TumAro/5_bar/README.md

# 5 Bar Linkage Mechanism
- Can get the parts list [here](specs/parts.md)

# TODO
- write up about the whole journey [here](https://blog.tumin.dev/5_bar)
- upload the updated STLs in the /specs folder
