TumAro/5_bar/specs/system.md

# COM (from axis)
- Left Cranker: 75mm
- Right Cranker: 75mm
- Left Coupler: 95mm
- Right Coupler: 95mm

# weights
- Left Cranker: 133gm
- Right Cranker: 133gm
- Left Coupler: 175gm
- Right Coupler: 175gm

# pivot (axis2axis)
- Left proximal = Right proximal: 150mm
- Left distal = Right distal: 200mm
- Base: 150mm
