TumAro/5_bar/markers/markers_A4.pdf

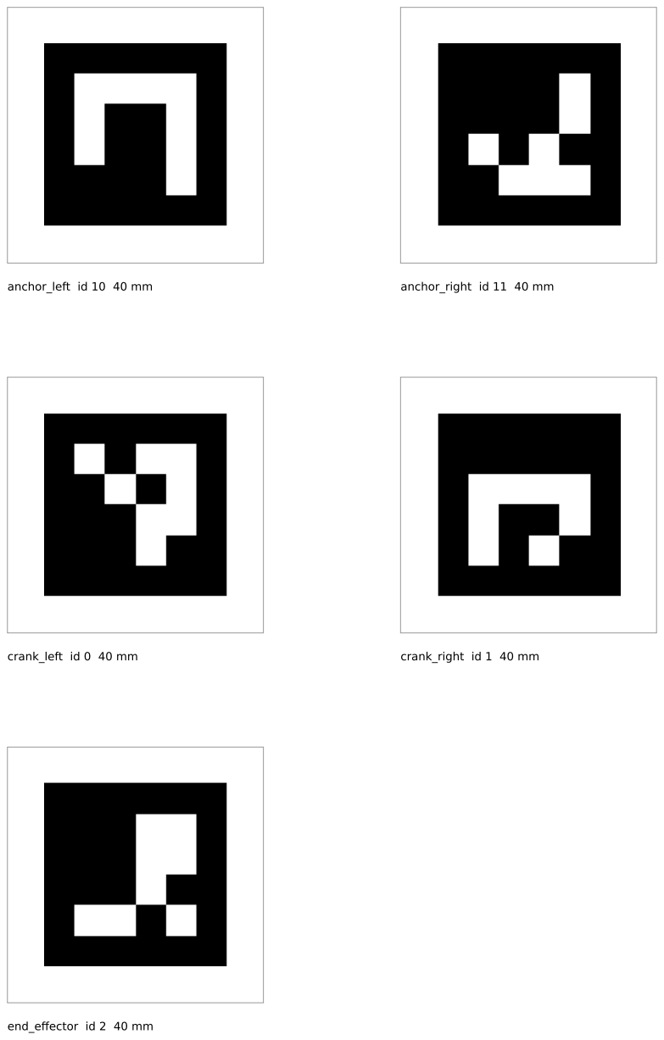
[picture p2: page 1]

anchor_left id 10 40 mm | anchor_right id 11 40 mm
crank_left id 0 40 mm | crank_right id 1 40 mm

end_effector id 2 40 mm
