TumAro/5_bar/markers/anchor_left_30mm.png

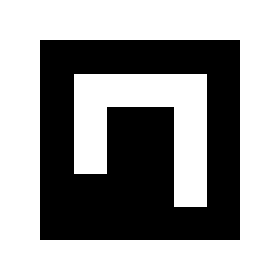
markers/anchor_left_30mm.png
