TumAro/5_bar/markers/anchor_right_30mm.png

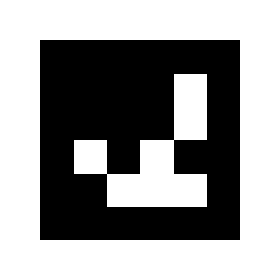
markers/anchor_right_30mm.png
