TumAro/5_bar/markers/crank_left_40mm.png

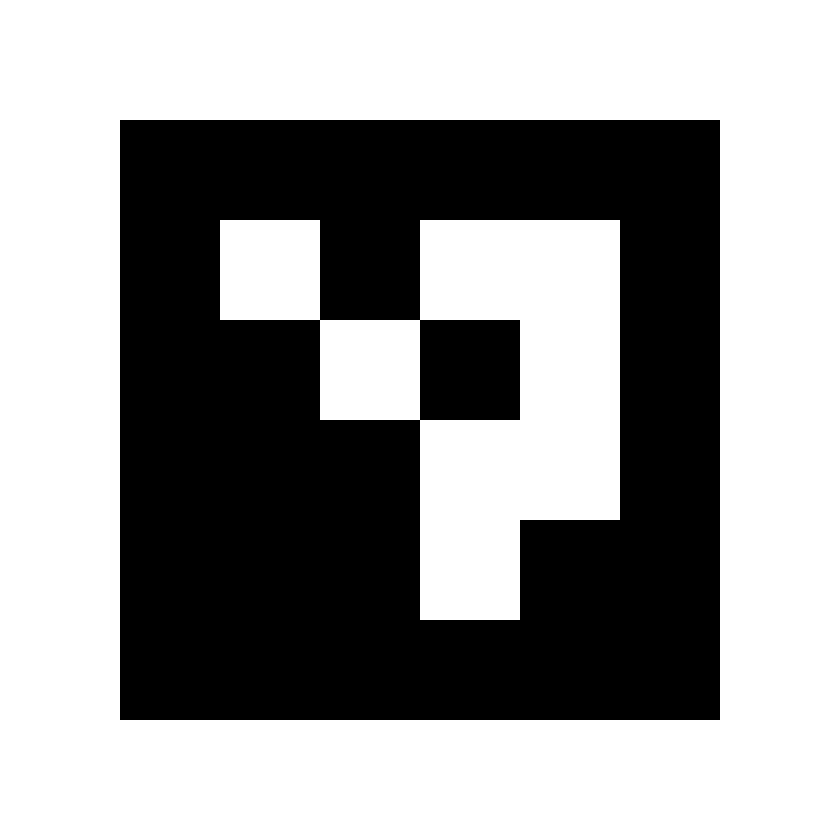
markers/crank_left_40mm.png
