TumAro/5_bar/markers/crank_right_40mm.png

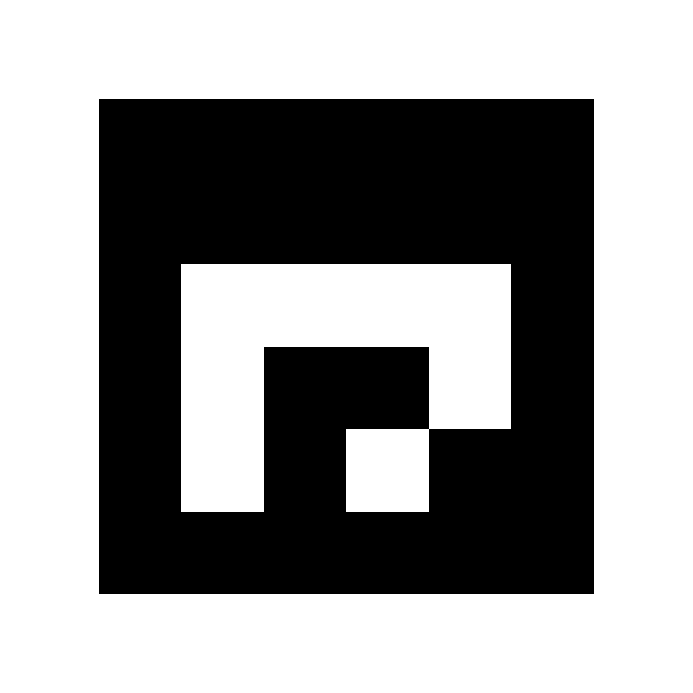
markers/crank_right_40mm.png
