TumAro/5_bar/markers/end_effector_40mm.png

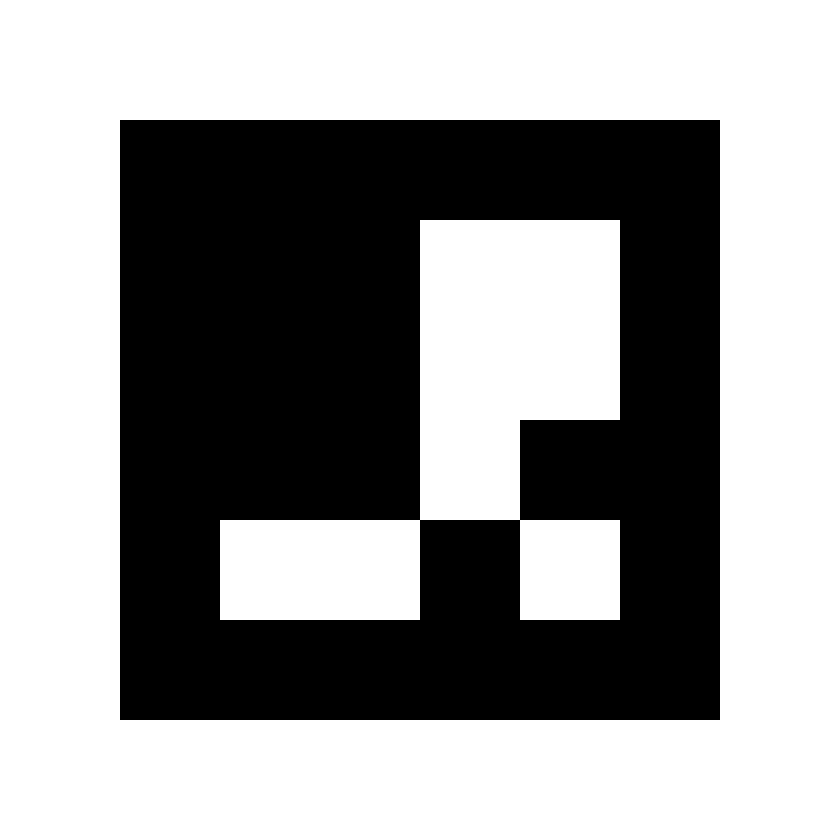
markers/end_effector_40mm.png
