TumAro/5_bar/specs/parts.md

# ROBU.in
- 2x MG958 [robu](https://robu.in/product/towerpro-mg958-digital-high-torque-metal-gear-servo-motor/)
- 1x SG90 servo mount -> [robu](https://robu.in/product/servo-mount-holder-bracket-sg90mg90/)
- 1x Arduino UNO R3 [robu](https://robu.in/product/arduino-uno-r3/)
- 4x Aluminium 2020 T-slot extrusion (300mm) [robu](https://robu.in/product/easymech-20x20-t-slot-aluminium-extrusion-profile-280-mm/) -> cut later
- 1x 6V 5A DC wall adapter -> [robu?](https://robu.in/product/pro-range-5v-5a-power-adapter/)
- 20x M5 T-nut -> [robu](https://robu.in/product/easymech-sliding-m5-t-nut-for-20x20-aluminium-profile-10-pcs/)
- 4x M8 nyloc nut -> [robu]()
- 1x SG90 180d -> [chandni]
- 1x barrel jack female screw terminal -> 5.5x2.5 mm -> [chandni]
- 2x choc block -> 15A, ~6 way  -> [chandni]
- 2x CNC alumunium 25T Futaba servo ~~disk~~ horn -> [chandni?]
- 1000uF 16v electrolytic capacitors -> [chandni]

# Hardware
- MDF base
- 8x 608zz bearings [only screws](https://onlyscrews.in/products/608-zz-deep-groove-ball-bearing-6x17x6)
- 4× M8×50mm hex bolt [only screws](https://onlyscrews.in/products/m8-x-50mm-hex-allen-socket-head-ss-304-screw-dia-8mm-length-50mm)
- 4x M8x60mm hex [chandni]
- ~~4× M8 nyloc nut [only screws](https://onlyscrews.in/products/m8-nyloc-nuts-ss304)~~
- 8× M8 flat washer [chandni]
- 20× M3×10mm socket screw [only screws](https://onlyscrews.in/products/hex-allen-socket-head-m3-x-10-screw-pack-of-20)
- 20× M3 nut [only screws](https://onlyscrews.in/products/m3-nut-ss-304)
- 20× M5×8mm socket screw [only screws](https://onlyscrews.in/products/hex-allen-socket-head-m5-x-8-screw-pack-of-20)
- 8x M5×12mm socket screw [only screws](https://onlyscrews.in/products/hex-allen-socket-head-m5-x-12-screw-pack-of-20)
- ~~20× M5 T-nut [only screws](https://onlyscrews.in/products/m4-profile-nuts-mild-steel-with-nickel-plating-for-3030-series-t-nut-hammer-nut-1)~~

# 3D Prints
- 8× 2020 end-cap 608 bearing holder -> [printables](https://www.printables.com/model/58585-608-type-zz-ss-bearing-holder-for-aluminium-extrus)
- 2× MG958 servo bracket -> [printables](https://www.printables.com/model/254115-simple-servo-mount)
- 1× coupler block (2× 22mm bearing holes + 4× M3 gripper holes)
- 1× parallel gripper -> [makerworld link in doc] or [chandni]
