TumAro/5_bar/specs/endcap_horn slot.stl

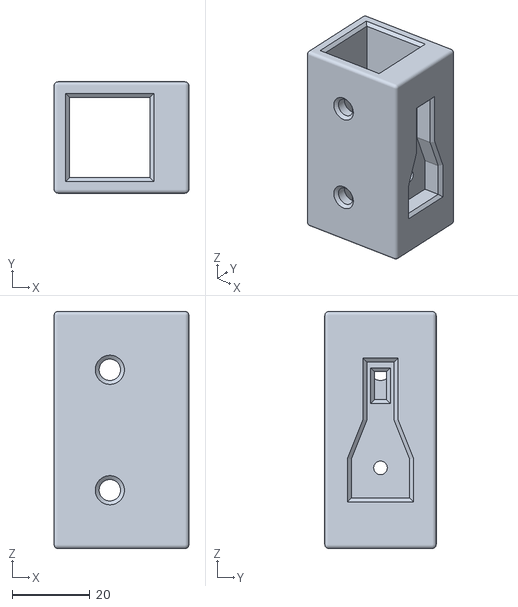
[picture p8: CAD file, 2026-08-31]
specs/endcap_horn slot.stl
34.7 x 28.7 x 61.0
