TumAro/5_bar/specs/base.dxf

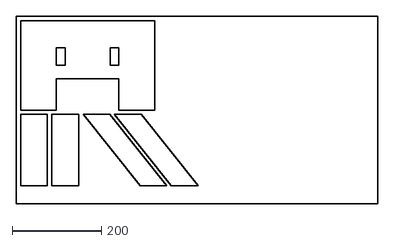
[picture p9: CAD file, 2026-07-23]
specs/base.dxf
809.9 x 419.9
