TumAro/5_bar/changes.md

# Non-filler edits (before → after)

Filler (um, like, you know, "yeah", "to be honest" kept where it was a real opener) removed silently except as listed. Each item: transcript → draft.

## Q1
- "What made me amused, not amused is a bad word, what made me excited for that" → "What made me excited for that" (false start dropped)
- "I was supposed to design the whole thing. Yeah, initially I was thinking that I would not make the hardware and just salvage it, not salvage, not salvage exactly, but you know work on something pre-existing" → "Initially I was thinking that I would not make the hardware and would work on something pre-existing" ("salvage" false start dropped)
- "had to make the BOA myself" → kept, marked [CHECK]
- "because the arm is a very popular thing, but there is not much parallel manipulator projects" → "there are not much" (grammar for "is" → "are": **this is a word change, revert if unwanted**)
- "since I can face the tedious problems, the face the hard problems" → "Since I face the hard problems" (stutter merge; "tedious" dropped)
- Sentence order kept; paragraph breaks added by me.
- "because of my own personal constraints, it could always be a live or a robot or a Bluetooth robot" kept as said ("live" left, possibly "LED"? not flagged by you, but see flags.md).

## Q2
- "I should have went for 3d printed but aluminium extrusions were the most prominent thing in my eyes" → kept, "3D printed".
- "and later a little bit later" → "A little bit later".
- "like it the system can be wobbly" → "The system can be wobbly".
- "cut off some parts are not available" → "I cannot have this and that thing cut off. Some parts are not available" (sentence split only).

## Q3
- "I did, it was very easy and obvious to use, but you know very, from my point of view" → "It was very easy and obvious to use, but from my point of view" (false start dropped)
- "I dived to the engineering drawing stuff" kept.
- "it's just drawing a very, yeah I don't know what to say" → kept as said (trailing off).

## Q4
- "so to fight with that what we did so to fight with that I did do" → "To fight with that, I did" (repeat dropped; "we did" dropped)
- "I can do I can work with SinPy" → "I can work with SinPy"
- "the process of calculation becomes very complicated" → "the calculation becomes very complicated" ("process of" dropped as repeat)
- "Onward kinematics" → "Forward kinematics" (obvious mishear, but also see flags.md; **silent fix, auditing**)
- "Python I used because I thought" → "For Python, I thought" (grammar glue)
- "Mathematica for the reliability of the symbolic map" → "symbolic math" (**word change**, "map" probably mishear)

## Q5
- "Left arm, right arm" order: transcript says "elbow out, right elbow out, right elbow in, left elbow out, left elbow in" (garbled start). Draft: "left elbow out, left elbow in, right elbow out, right elbow in" (**reconstructed, the first item was lost in transcription**)
- "and yeah, that thing" dropped.
- "So no, for working process" → "For the working process".

## Q6
- "tan or r tan" kept and marked.
- "with the help, the solution is not working" → "with the solution not working" ("with the help" dropped as unclear).

## Q7
- Opening sentence kept garbled, marked.
- "round and round, and here we go, a merry-go-round" → "round and round, a merry-go-round" ("and here we go" dropped).
- "that is also not a viable thing or a possible thing" → "That is also not a viable thing" ("or a possible thing" dropped).

## Q9
- Kept the slip "Hamiltonian... sorry the Lagrange" as said.
- "I totally forgot to add the I omega square, the angular momentum in the Hamiltonian" kept.

## Q10
- Transcript shows "But after a lot of I had to realize the final conflict length" → kept.
- "That is the final length for now." kept.

## Q12/13
- Merged two recordings' worth of content into one section (one recording, 13.ogg).
- "Okay, the whole designing process" → "The whole designing process".
- "the wood was very unstable, like it was for the wood, the CNC cutting machine" → "the wood was very unstable. For the CNC cutting machine, we took a plywood" (**transcript garbled, kept order, split sentence**)
- "the design I'll provide again" kept as an aside.
- "And yeah, that supported the weight by a lot" → "That supported the weight by a lot".
- "There was a lot of moving process" kept.

## Q14
- Kept the whole answer. "I did the calculation for something. Right now I forgot what." kept.

## Q15
- "Around the world" kept and marked.
- "Like, you know, when I said I was getting the in-caps" → "When I said I was getting the endcaps" ("in-caps" → "endcaps", **mishear fix, silent**)
- "clicked up the Arduino" → "hooked up the Arduino" (**mishear fix, silent**)
- "And other times, errands had me one month." kept.
- "And if the hardware was working or not." (repeat) dropped.

## Q16
- "from the raw 98, 99, the raw values" kept.
- "which is acting as a feedback loop, kind of feedback loop without any present encoder" → "which is acting as a kind of feedback loop without any present encoder" (repeat merged)

## Q17
- "The ILC converse is happened" → "The ILC converge happened" (**mishear fix, marked in [CHECK]**)
- "bad join PID values" → "bad joint PID values" (**silent**)

## Q18
- "arco" → "ArUco" throughout (spelling).
- "work with it" kept.
- "I did something I had to put the picture to this side exactly" kept (garbled).

## Q20-24
- File `20-24.ogg` is one recording. I split it by content: the first part → Q20, the "sim versus real gap number" part → Q21, the last part → Q24. Q22/Q23 not covered.
- "ARUKO" → "ArUco".
- "Actually, I did not check if the ARUKO angles were working properly or not." kept.
- "I cannot conclude the model what it is" kept.
- "I would not start to just making the whole software hardware and fiber, instead, I need to bring some properly." kept, marked.
- "It does. I won't say it does not" → "I won't say it does not" (false start dropped).
- "In this sector" kept.
- "I make one thing and it can do everything" kept.
