TumAro/5_bar/(commit log)

2026-06-23 Revise parts list with updated links and additions
    Updated links in the hardware and 3D prints sections for clarity and added a new source for the parallel gripper.
2026-07-07 fix: tomli -> tomllib
    [fk.py, ik.py]
2026-07-07 fix: clamp in acos
    [fk.py, ik.py]
2026-07-23 tune: put base design for cnc + put a system.md for measurements
    [base.dxf]
2026-07-27 feat: included stl files
2026-08-31 stl: endcap for horn slot
    [endcap_horn slot.stl]
2026-09-22 arduino: added .ino file for servo test
2026-09-23 arduino: 90 deg offset fix
    [five_bar_servo.ino, serial_link.py]
2026-09-24 arduino: left and right servo angle limits
